erdemcanaz/Electronic-Load/Arşiv/ERDEM-GÜLCE/ERDEM/mosfet Vds current threshold.png

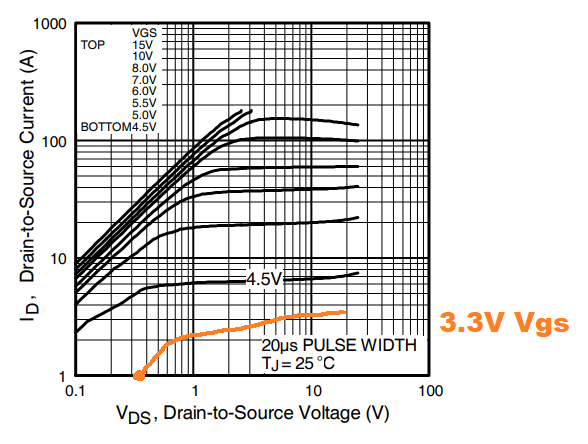
Arşiv/ERDEM-GÜLCE/ERDEM/mosfet Vds current threshold.png
