erdemcanaz/Electronic-Load/Arşiv/ERDEM-GÜLCE/LT SPICE FINISHED CIRCUITS/FINISHED DUMMY LOAD/FINISHED REVERSE VOLTAGE PROTECTION.png

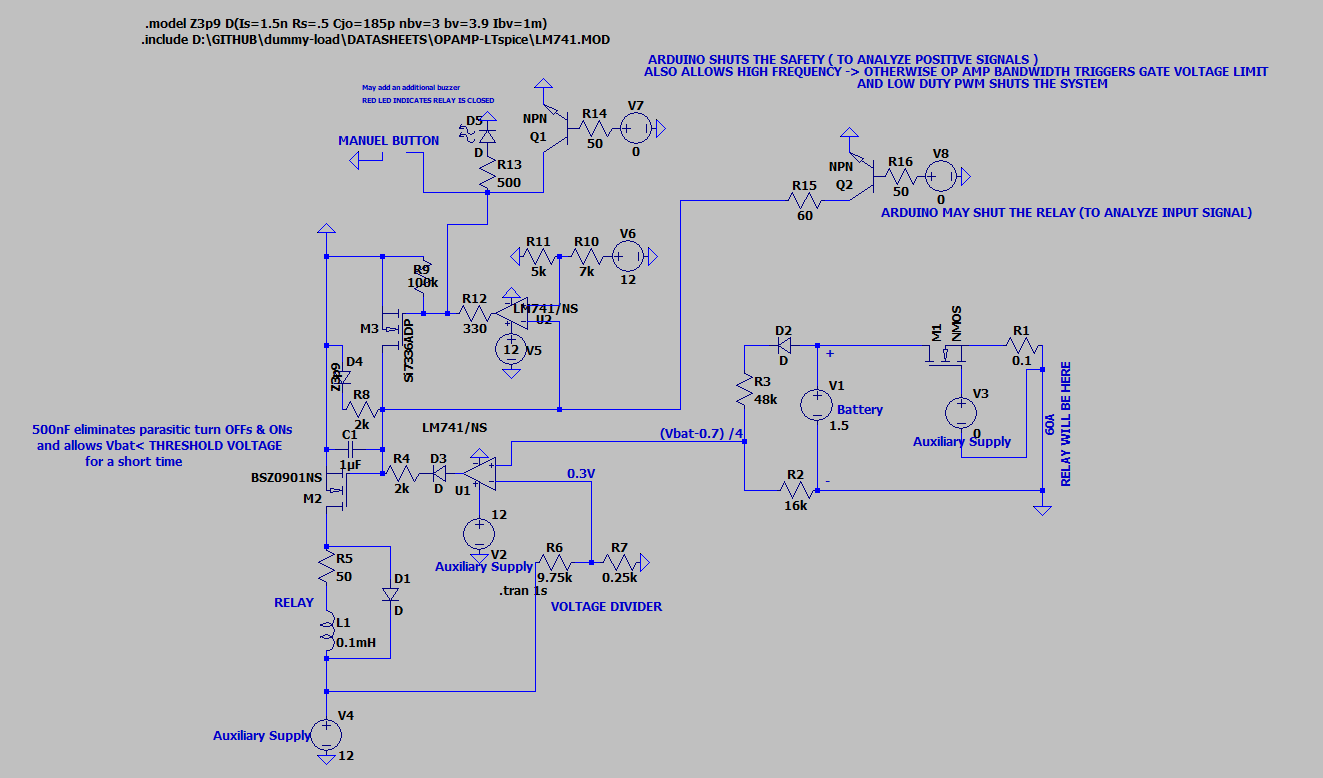
Arşiv/ERDEM-GÜLCE/LT SPICE FINISHED CIRCUITS/FINISHED DUMMY LOAD/FINISHED REVERSE VOLTAGE PROTECTION.png
