erdemcanaz/Electronic-Load/Arşiv/ERDEM-GÜLCE/LT SPICE FINISHED CIRCUITS/FINISHED DUMMY LOAD/MOSFET CONTROL PART.png

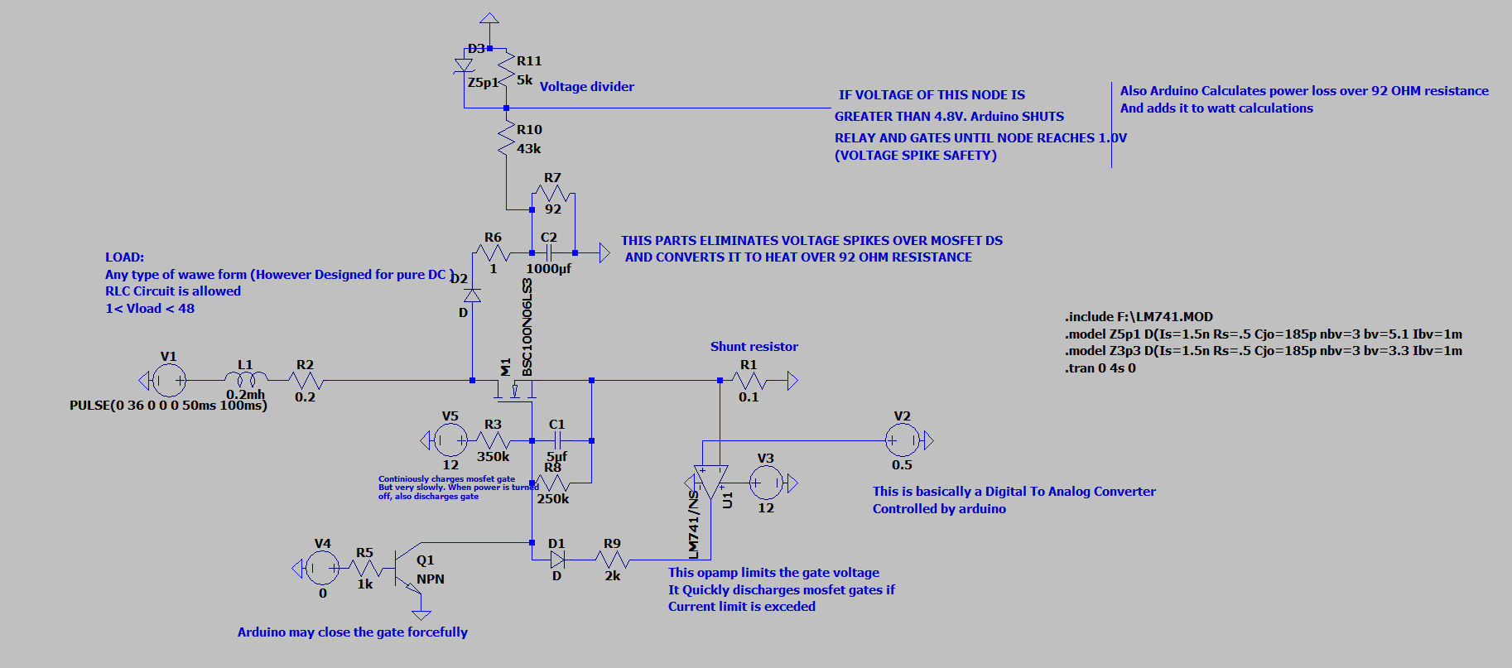
Arşiv/ERDEM-GÜLCE/LT SPICE FINISHED CIRCUITS/FINISHED DUMMY LOAD/MOSFET CONTROL PART.png
