erdemcanaz/Electronic-Load/Arşiv/ERDEM-GÜLCE/LT SPICE FINISHED CIRCUITS/R-OP AMP CURRENT CONTROL DC/image.png

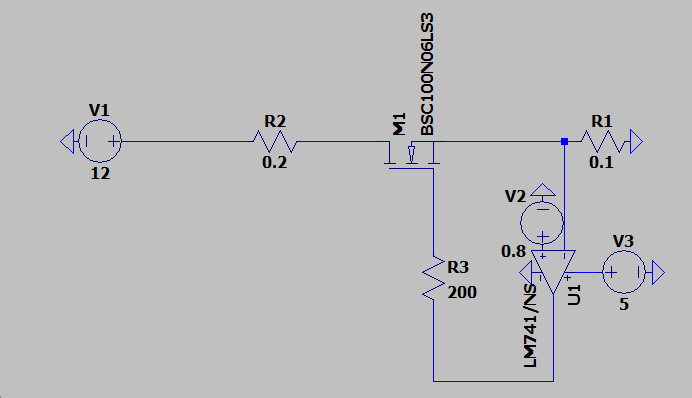
Arşiv/ERDEM-GÜLCE/LT SPICE FINISHED CIRCUITS/R-OP AMP CURRENT CONTROL DC/image.png
