erdemcanaz/Electronic-Load/Arşiv/ERDEM-GÜLCE/LT SPICE FINISHED CIRCUITS/REVERSE & LOW VOLTAGE PROTECTION WITH RELAY/image.png

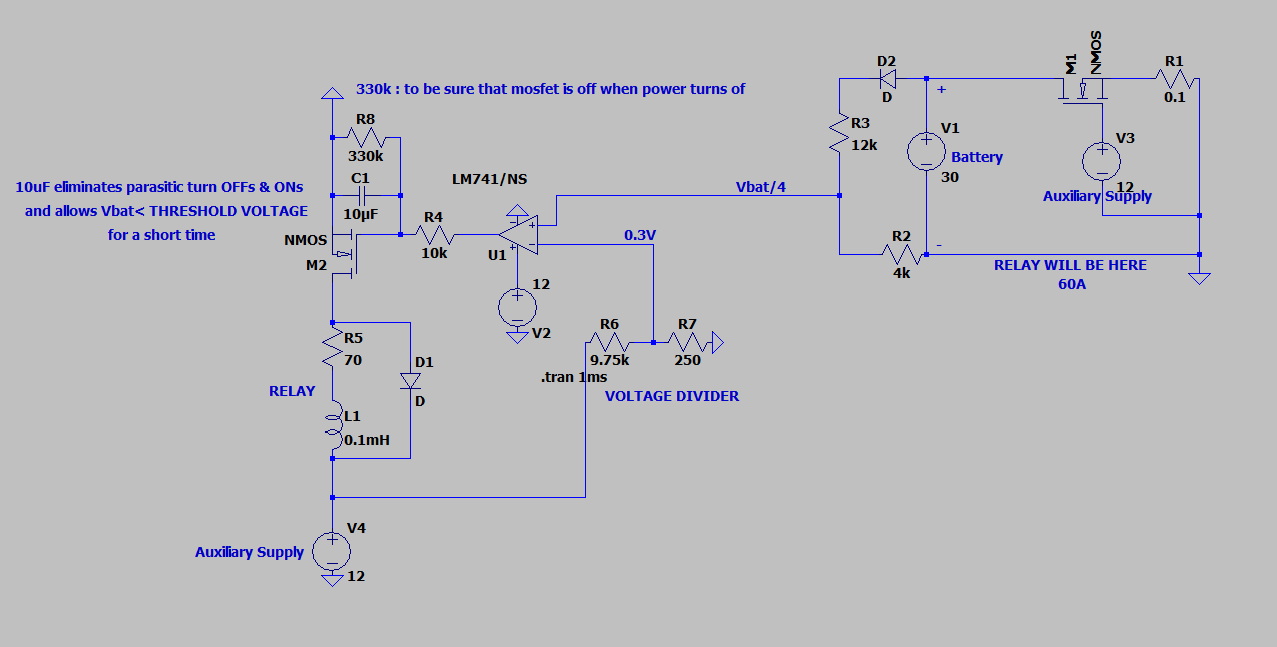
Arşiv/ERDEM-GÜLCE/LT SPICE FINISHED CIRCUITS/REVERSE & LOW VOLTAGE PROTECTION WITH RELAY/image.png
