erdemcanaz/Electronic-Load/Arşiv/ERDEM-GÜLCE/LT SPICE FINISHED CIRCUITS/REVERSE & LOW VOLTAGE PROTECTION WITH RELAY/Quick turn on relay- slow turn of relay.png

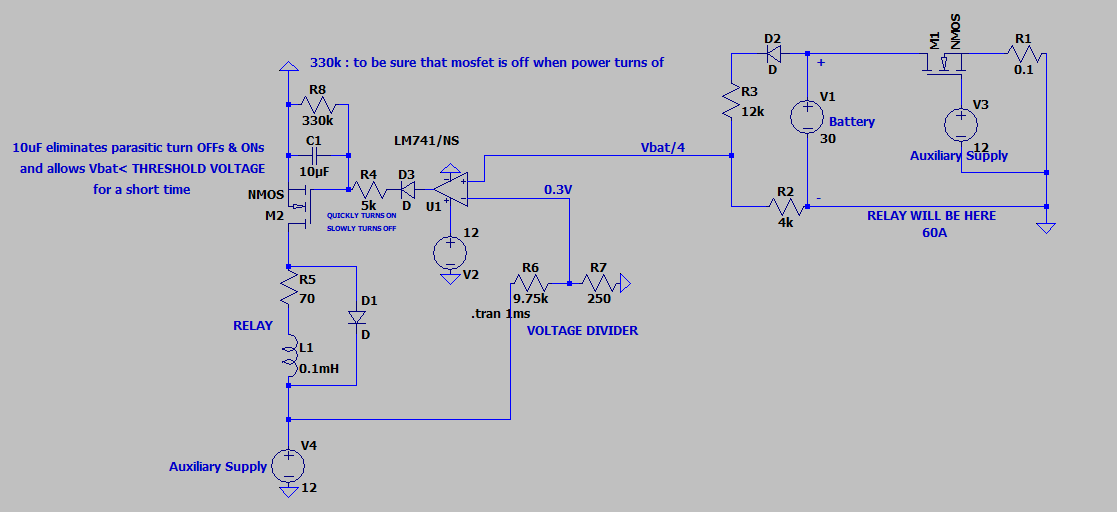
Arşiv/ERDEM-GÜLCE/LT SPICE FINISHED CIRCUITS/REVERSE & LOW VOLTAGE PROTECTION WITH RELAY/Quick turn on relay- slow turn of relay.png
