erdemcanaz/Electronic-Load/Arşiv/ERDEM-İLİM/PCB çizimleri/PCB çizimleri.step

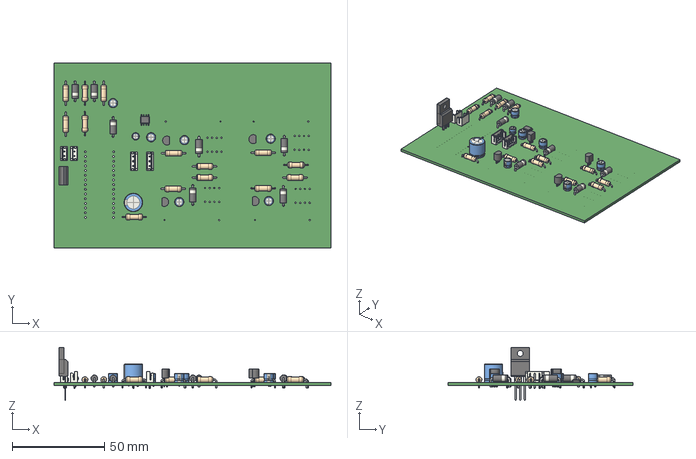
[picture p8: CAD file, 2021-12-23]
Arşiv/ERDEM-İLİM/PCB çizimleri/PCB çizimleri.step
150.0 x 100.0 x 28.9 mm
