erdemcanaz/Electronic-Load/Arşiv/ERDEM-GÜLCE/HOW TO USE GITHUB.txt

1: GITHUB going back in history: https://youtu.be/nsXx3npUOWY
