erdemcanaz/Electronic-Load/Arşiv/ERDEM-İLİM/PCB çizimleri/schematic/PCB çizimleri.pdf

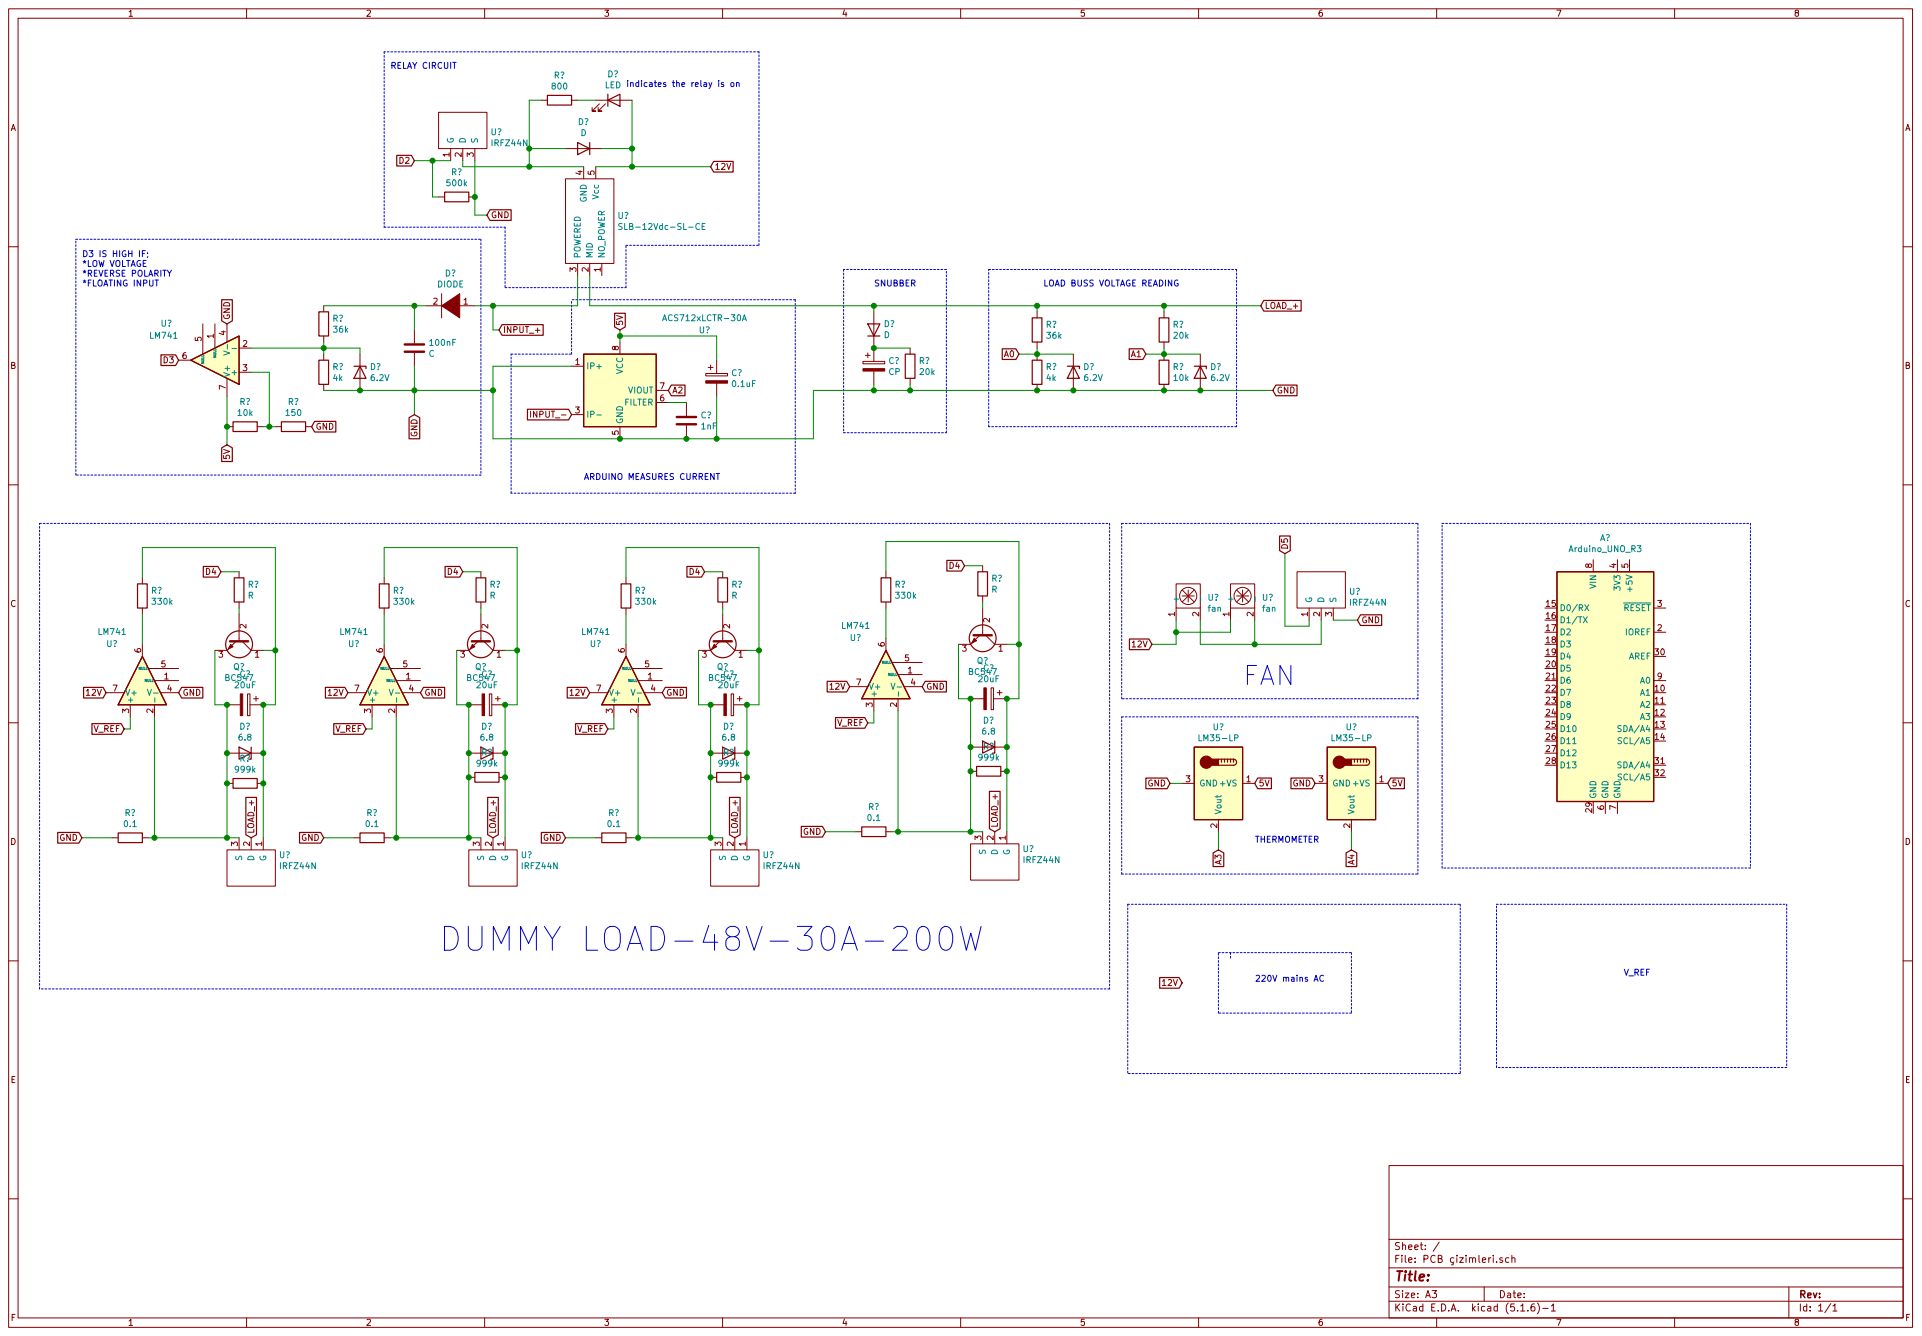
[picture p9: page 1]

indicates the relay is on

4 Vcc 5 U?SLB-12Vdc-SL-CE D?

D3 IS HIGH IF; *LOW VOLTAGE

LOAD BUSS VOLTAGE READING

File: PCB çizimleri.sch Sheet: /
