erdemcanaz/Electronic-Load/Simulation/Simulation.asc

C1: cap; 1µF; IC=0
C2: cap; 1µF
C3: cap; 1µF
C4: cap; 1µF
D1: zener; BZX84C8V2LT116
D2: zener; BZX84C8V2LT116
D3: zener; BZX84C8V2LT116
D4: zener; BZX84C8V2LT116
D5: LED
D6: LED
D7: LED
M1: nmos; IRFZ46N
M2: nmos; IRFZ46N
M3: nmos; IRFZ46N
M4: nmos; IRFZ46N
M5: nmos; IRFZ46N
Q1: npn; BC547B
Q2: npn; BC547B
Q3: npn; BC547B
Q4: npn; BC547B
R1: res; 0.1
R2: res; 0.2
R3: res; 1200k
R4: res; 10k
R5: res; 0
R6: res; 1
R7: res; 500k
R9: res; 1k
R10: res; 1k
R11: res; 10000k
R12: res; 0.1
R13: res; 500k
R16: res; 10000k
R17: res; 0.1
R18: res; 500k
R20: res; 2.3k
R22: res; 1100
R23: res; 0.01
R24: res; 10000k
R25: res; 0.1
R26: res; 500k
R29: res; 10000k
R30: res; 80
R31: res; 80
R32: res; 100k
R33: res; 3.2k
R34: res; 0.1k
R35: res; 1100
R36: res; 1100
U1: opamp2; LM741/NS
U2: opamp2; LM741/NS
U3: opamp2; LM741/NS
U4: opamp2; LM741/NS
U5: opamp2; LM741/NS
U6: opamp2; LM741/NS
V1: voltage; 5
V2: voltage; 3.3V
V3: voltage; 12V
V5: voltage; 0.3
Named nets: 0, IREF, 12V, 3.3V, HALT
.include D:\\GITHUB\\Electronic-Load\\Simulation\\LM741.MOD
INPUT+
-INPUT
max 0.5V
max 200k
max 10k
max 500
.tran 0 12 0
Current Adjustment
~1V
LED INDICATES LOW DRAIN VOLTAGE
FUSE
LED INDICATES FAN IS ACTIVATED
Grounds mosfet gates
POT1
POT2
POT3
SWITCH
FAN CURRENT LIMIT
Power supply
linear voltage regulator
FANS
