erdemcanaz/Electronic-Load/Arşiv/ERDEM-İLİM/LT spice models/draft1.asc

C1: cap; 4.7nF
R1: res; 3.3k
V1: voltage; PULSE(1 3 0.00025 1ns 1ns 0.00025 0.0005)
Named nets: 0
.tran 0.01
Exp4/ part2/ Q1/ a/ 2kHz,3.3kohm,4.7nF
Erdem Canaz/ 2374676
