erdemcanaz/Electronic-Load/Arşiv/ERDEM-GÜLCE/LT spice simulations/Draft1.asc

R1: res
R2: res
R3: res
R4: res
R5: res
R6: res
R7: res
R8: res
R9: res
R10: res
R11: res
R12: res
R13: res
R14: res
R15: res
R16: res
R17: res
R18: res
R19: res
R20: res
R21: res
R22: res
R23: res
R24: res
R25: res
R26: res
R27: res
R28: res
R29: res
R30: res
R31: res
R32: res
R33: res
R34: res
R35: res
R36: res
R37: res
R38: res
R39: res
R40: res
R41: res
R42: res
R43: res
R44: res
R45: res
R46: res
R47: res
R48: res
V1: voltage; 5
Named nets: 0
