erdemcanaz/Electronic-Load/Arşiv/ERDEM-GÜLCE/LT spice simulations/FINISHED DUMMY LOAD MOSFET PART.asc

C1: cap; 5µf
C2: cap; 1000µf
D1: diode
D2: diode
D3: zener; Z5p1
L1: ind; 0.2mh
M1: nmos; BSC100N06LS3
Q1: npn
R1: res; 0.1
R2: res; 0.2
R3: res; 350k
R5: res; 1k
R6: res; 1
R7: res; 92
R8: res; 250k
R9: res; 2k
R10: res; 43k
R11: res; 5k
U1: opamp2; LM741/NS
V1: voltage; SINE(20 18 20 0 0 0 0)
V2: voltage; 0.5
V3: voltage; 12
V4: voltage; 0
V5: voltage; 12
Named nets: 0
.include F:\\LM741.MOD
.tran 0 30s 0
.model Z5p1 D(Is=1.5n Rs=.5 Cjo=185p nbv=3 bv=5.1 Ibv=1m
.model Z3p3 D(Is=1.5n Rs=.5 Cjo=185p nbv=3 bv=3.3 Ibv=1m
IF VOLTAGE OF THIS NODE IS
GREATER THAN 4.8V. Arduino SHUTS
RELAY AND GATES UNTIL NODE REACHES 1.0V
THIS PARTS ELIMINATES VOLTAGE SPIKES OVER MOSFET DS
AND CONVERTS IT TO HEAT OVER 92 OHM RESISTANCE
(VOLTAGE SPIKE SAFETY)
Also Arduino Calculates power loss over 92 OHM resistance
And adds it to watt calculations
This is basically a Digital To Analog Converter
Controlled by arduino
This opamp limits the gate voltage
It Quickly discharges mosfet gates if
Current limit is exceded
Continiously charges mosfet gate
But very slowly. When power is turned
off, also discharges gate
Arduino may close the gate forcefully
Voltage divider
Shunt resistor
LOAD:
Any type of wawe form (However Designed for pure DC )
RLC Circuit is allowed
1< Vload < 48
