erdemcanaz/Electronic-Load/Arşiv/ERDEM-GÜLCE/LT spice simulations/FINISHED REVERSE VOLTAGE PROTECTION WITH RELAY.asc

C1: cap; 1µF; IC=7
D1: diode
D2: diode
D3: diode
D4: diode
D5: LED
L1: ind; 0.1mH
M1: nmos
M2: nmos; BSZ0901NS
M3: nmos; Si7336ADP
Q1: npn
Q2: npn
R1: res; 0.1
R2: res; 8k
R3: res; 24k
R4: res; 2k
R5: res; 50
R6: res; 9.75k
R7: res; 0.25k
R8: res; 3k
R9: res; 100k
R10: res; 7k
R11: res; 5k
R12: res; 330
R13: res; 500
R14: res; 330
R15: res; 60
R16: res; 50
U1: opamp2; LM741/NS
U2: opamp2; LM741/NS
V1: voltage; 12
V2: voltage; 12
V3: voltage; 0
V4: voltage; 12
V5: voltage; 12
V6: voltage; 12
V7: voltage; 0
V8: voltage; 0
Named nets: 0
.tran 1s
.include D:\\GITHUB\\dummy-load\\DATASHEETS\\OPAMP-LTspice\\LM741.MOD
RELAY WILL BE HERE
60A
RELAY
VOLTAGE DIVIDER
500nF eliminates parasitic turn OFFs & ONs
and allows Vbat< THRESHOLD VOLTAGE
Auxiliary Supply
Auxiliary Supply
Battery
+
-
(Vbat-0.7) /4
0.3V
for a short time
Auxiliary Supply
MANUEL BUTTON
ARDUINO SHUTS THE SAFETY ( TO ANALYZE POSITIVE SIGNALS )
RED LED INDICATES RELAY IS CLOSED
ARDUINO MAY SHUT THE RELAY (TO ANALYZE INPUT SIGNAL)
ALSO ALLOWS HIGH FREQUENCY -> OTHERWISE OP AMP BANDWIDTH TRIGGERS GATE VOLTAGE LIMIT
.model Z3p9 D(Is=1.5n Rs=.5 Cjo=185p nbv=3 bv=3.9 Ibv=1m)
May add an additional buzzer
AND LOW DUTY PWM SHUTS THE SYSTEM
