erdemcanaz/Electronic-Load/Arşiv/ERDEM-GÜLCE/LT spice simulations/RL- OP AMP CURRENT CONTROL FOR ALTERNATING DC.asc

C1: cap; 5µf
C2: cap; 2200µF
D1: diode
D2: diode
D3: zener; Z5p1
L1: ind; 0.2mh
M1: nmos; BSC100N06LS3
Q1: npn
R1: res; 0.1
R2: res; 0.2
R3: res; 30k
R4: res; 999k
R5: res; 1k
R6: res; 5k
R7: res; 92
U1: opamp2; LM741/NS
V1: voltage; SINE(12 12 50)
V2: voltage; 0.1
V3: voltage; 12
V4: voltage; 0
Named nets: 0
.include F:\\LM741.MOD
.tran 0 100ms 0
.model Z5p1 D(Is=1.5n Rs=.5 Cjo=185p nbv=3 bv=5.1 Ibv=1m
.model Z3p3 D(Is=1.5n Rs=.5 Cjo=185p nbv=3 bv=3.3 Ibv=1m
