erdemcanaz/Electronic-Load/Arşiv/ERDEM-GÜLCE/LT spice simulations/RL- OP AMP CURRENT CONTROL FOR DC.asc

C1: cap; 1µf
L1: ind; 0.001mH
M1: nmos; BSC100N06LS3
R1: res; 0.1
R2: res; 0.2
R3: res; 5k
R4: res; 4k
U1: opamp2; LM741/NS
V1: voltage; PULSE(0 48 0 0 0 25us 50us)
V2: voltage; 1
V3: voltage; 12
Named nets: 0
.include F:\\LM741.MOD
.tran 0 50ms 0
