erdemcanaz/Electronic-Load/Arşiv/ERDEM-GÜLCE/LT spice simulations/REVERSE VOLTAGE PROTECTION WITH RELAY.asc

C1: cap; 10µF
D1: diode
D2: diode
D3: diode
L1: ind; 0.1mH
M1: nmos
M2: nmos
R1: res; 0.1
R2: res; 4k
R3: res; 12k
R4: res; 5k
R5: res; 70
R6: res; 9.75k
R7: res; 250
R8: res; 330k
U1: opamp2; LM741/NS
V1: voltage; 30
V2: voltage; 12
V3: voltage; 12
V4: voltage; 12
Named nets: 0
.tran 1ms
.include D:\\GITHUB\\dummy-load\\DATASHEETS\\OPAMP-LTspice\\LM741.MOD
RELAY WILL BE HERE
60A
RELAY
VOLTAGE DIVIDER
330k : to be sure that mosfet is off when power turns of
10uF eliminates parasitic turn OFFs & ONs
and allows Vbat< THRESHOLD VOLTAGE
Auxiliary Supply
Auxiliary Supply
Battery
+
-
Vbat/4
0.3V
for a short time
QUICKLY TURNS ON
SLOWLY TURNS OFF
Auxiliary Supply
