erdemcanaz/Electronic-Load/Arşiv/ERDEM-GÜLCE/LT spice simulations/R- OP AMP CURRENT CONTROL DC.asc

M1: nmos; BSC100N06LS3
R1: res; 0.1
R2: res; 0.2
R3: res; 200
U1: opamp2; LM741/NS
V1: voltage; 12
V2: voltage; 0.8
V3: voltage; 5
Named nets: 0
.include F:\\LM741.MOD
.tran 0 1s 0
