erdemcanaz/Electronic-Load/PCB/electronic load/electronic load.kicad_pcb

## KiCad design PCB/electronic load/electronic load.kicad_pcb (2021-12-25)

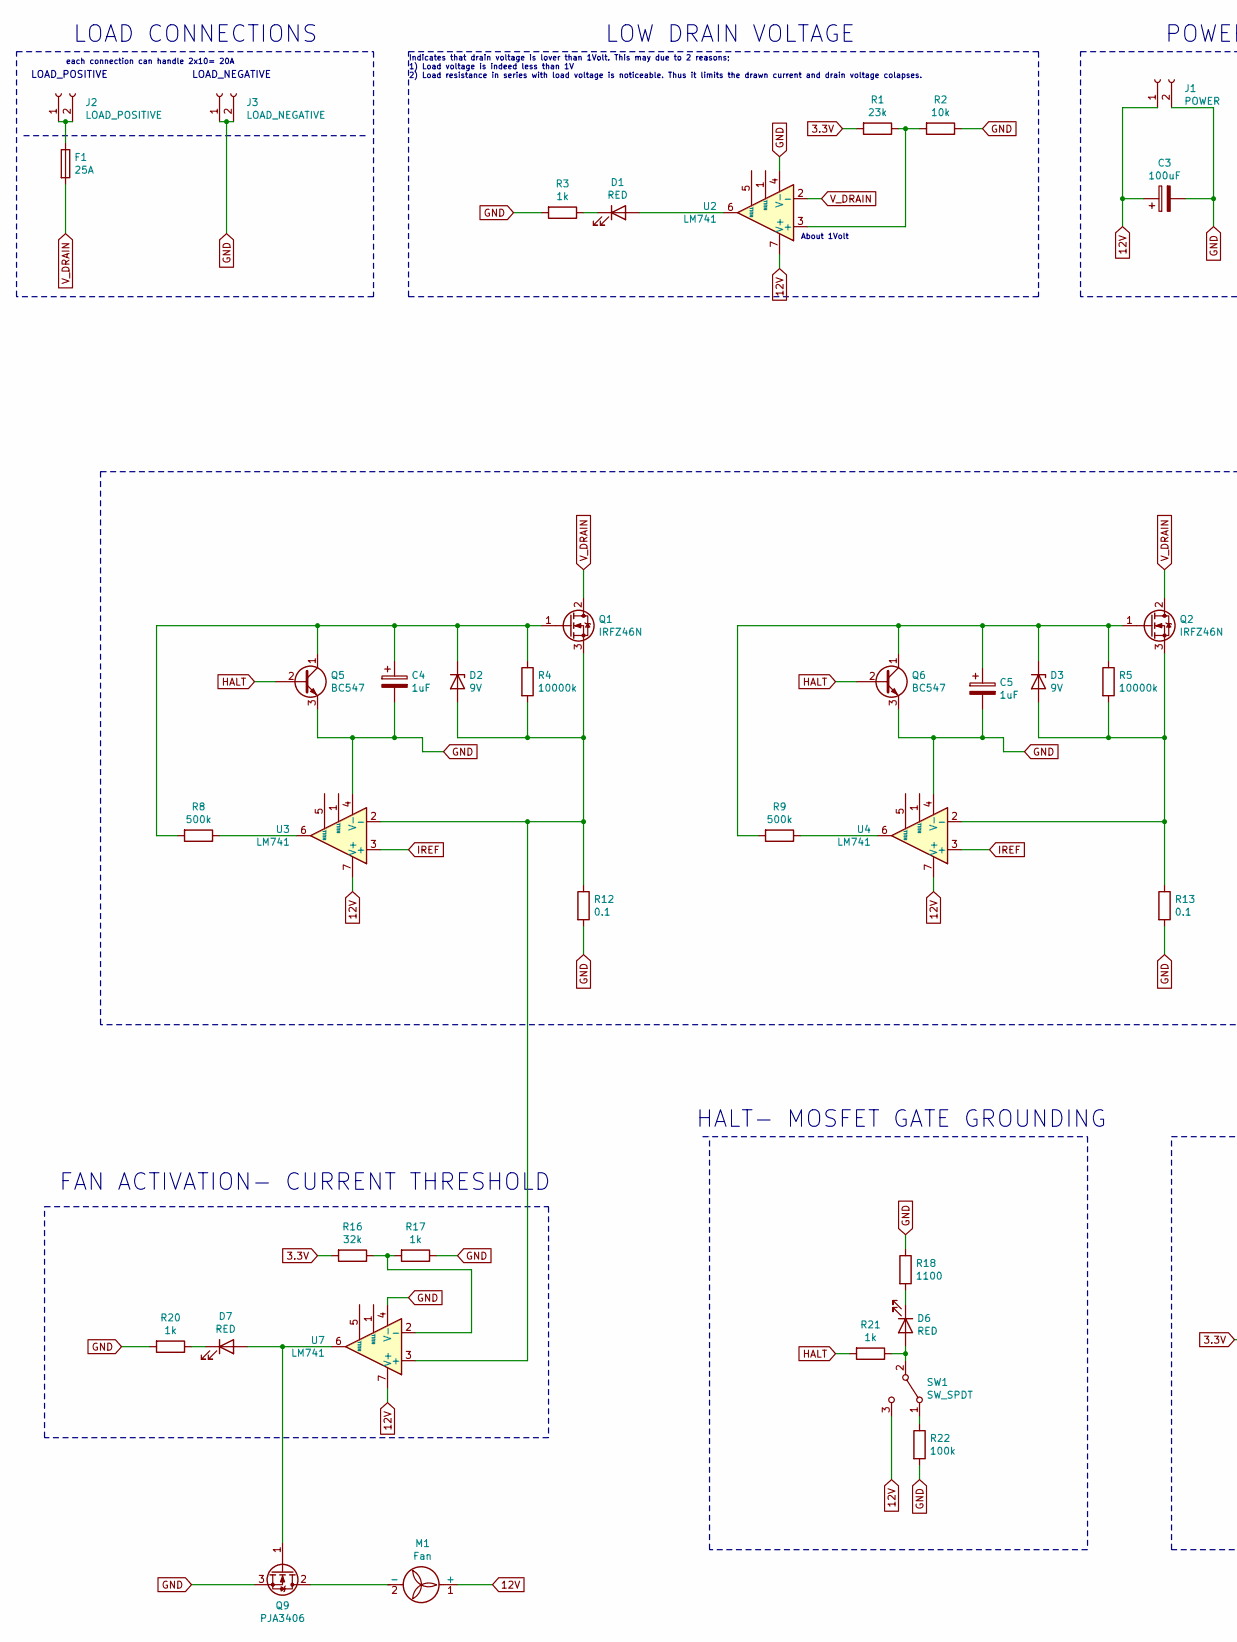
[picture p10: schematic electronic load.sch, part in row 1, column 1]

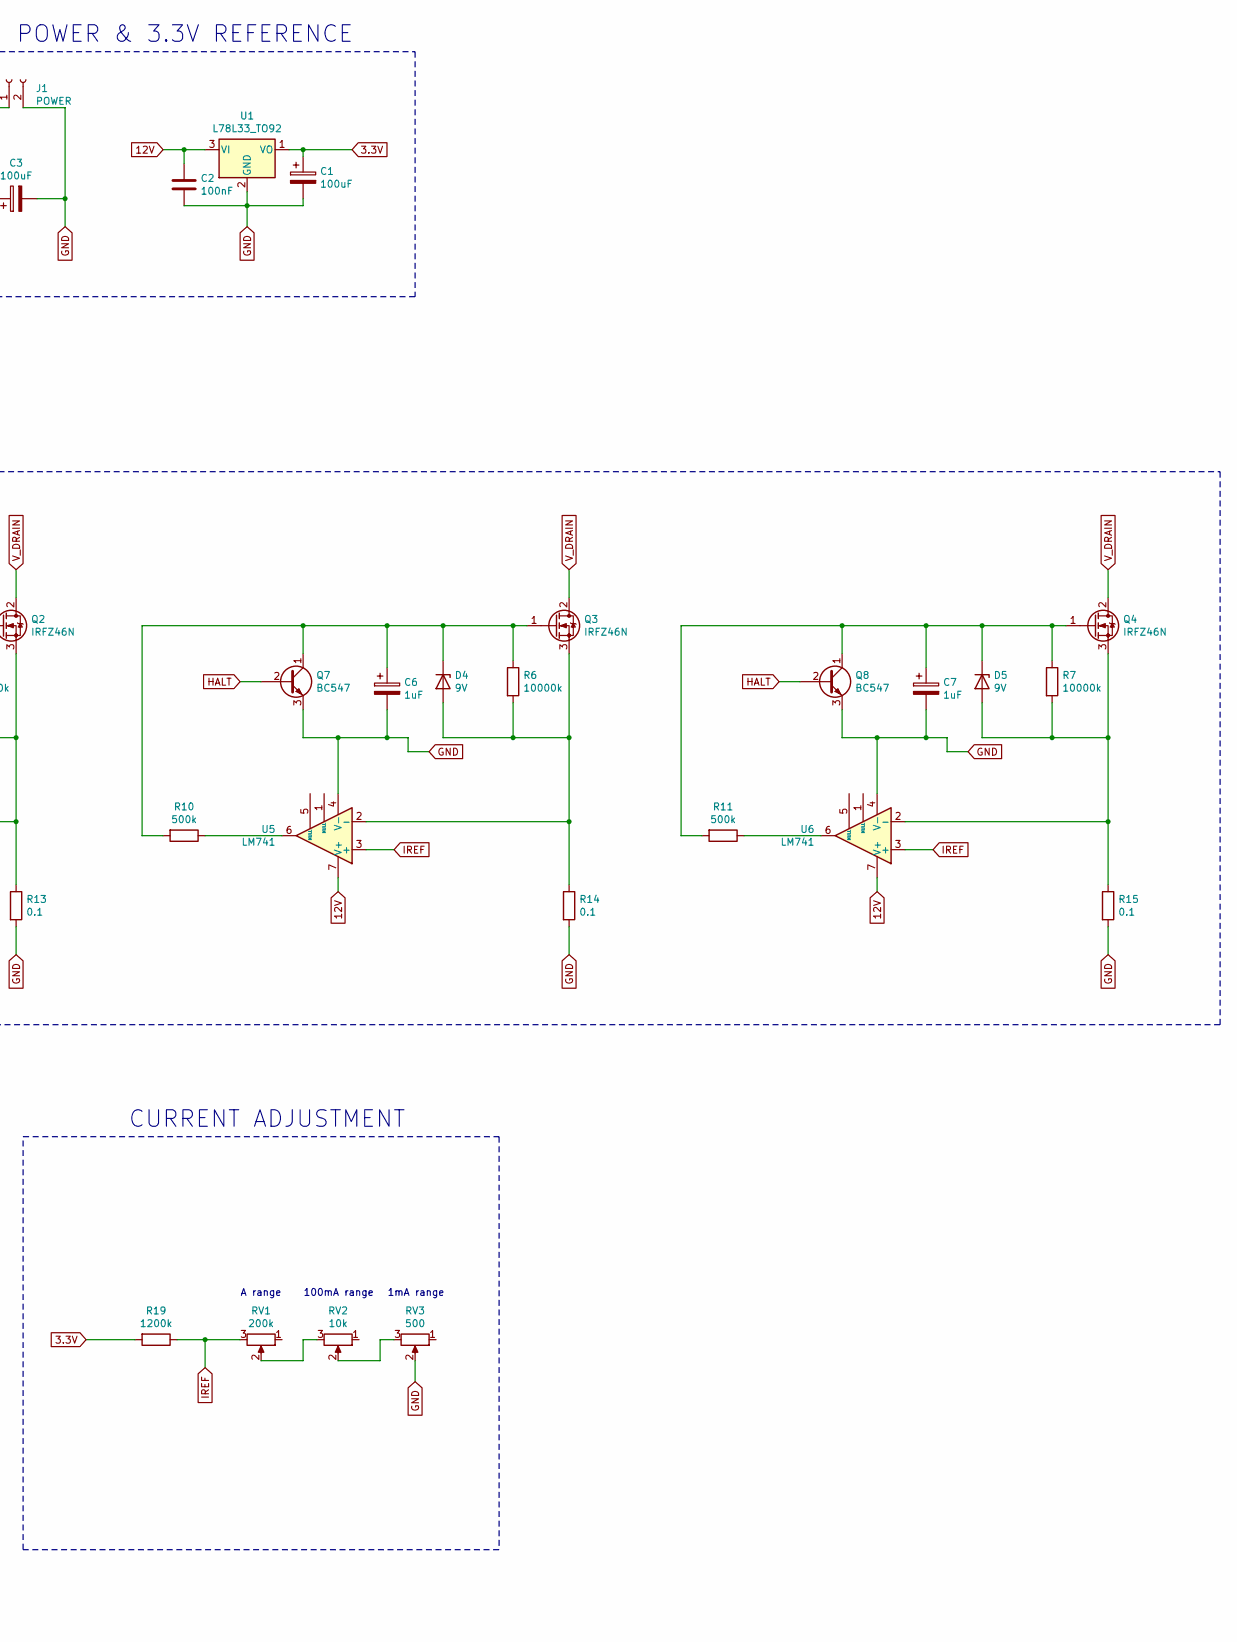
[picture p11: schematic electronic load.sch, part in row 1, column 2]

Parts:
C1, C3: 100uF; CP_Radial_D5.0mm_P2.00mm
C2: 100nF; CP_Radial_D5.0mm_P2.00mm
C4, C5, C6, C7: 1uF; CP_Radial_D5.0mm_P2.00mm
D1, D6, D7: RED; LED_D3.0mm_FlatTop
D2, D3, D4, D5: 9V; D_A-405_P12.70mm_Horizontal
F1: 25A; fuse
J1: POWER; klemens 2li
J2: LOAD_POSITIVE; klemens 2li
J3: LOAD_NEGATIVE; klemens 2li
M1: Fan; PinHeader_1x02_P2.00mm_Vertical
Q1, Q2, Q3, Q4: IRFZ46N; TO-220-3_Horizontal_TabUp
Q5, Q6, Q7, Q8: BC547; TO-92_Inline_Wide
Q9: PJA3406; SOT-23
R1: 23k; R_Axial_DIN0207_L6.3mm_D2.5mm_P7.62mm_Horizontal
R2: 10k; R_Axial_DIN0207_L6.3mm_D2.5mm_P7.62mm_Horizontal
R3, R17, R20, R21: 1k; R_Axial_DIN0207_L6.3mm_D2.5mm_P7.62mm_Horizontal
R4, R5, R6, R7: 10000k; R_Axial_DIN0207_L6.3mm_D2.5mm_P7.62mm_Horizontal
R8, R9, R10, R11: 500k; R_Axial_DIN0207_L6.3mm_D2.5mm_P7.62mm_Horizontal
R12, R13, R14, R15: 0.1; R_Axial_Power_L25.0mm_W9.0mm_P27.94mm
R16: 32k; R_Axial_DIN0207_L6.3mm_D2.5mm_P7.62mm_Horizontal
R18: 1100; R_Axial_DIN0207_L6.3mm_D2.5mm_P7.62mm_Horizontal
R19: 1200k; R_Axial_DIN0207_L6.3mm_D2.5mm_P7.62mm_Horizontal
R22: 100k; R_Axial_DIN0207_L6.3mm_D2.5mm_P7.62mm_Horizontal
RV1: 200k; pot
RV2: 10k; pot
RV3: 500; pot
SW1: SW_SPDT; PinHeader_1x03_P2.00mm_Horizontal
U1: L78L33_TO92; TO-92_Inline_Wide
U2, U3, U4, U5, U6, U7: LM741; DIP-8_W7.62mm

Connections:
3.3V: C1.1, R1.2, R16.2, R19.2, U1.1 (VO)
12V: C2.1, C3.1, J1.1, M1.1 (+), SW1.3 (C), U1.3 (VI), U2.7 (V+), U3.7 (V+), U4.7 (V+), U5.7 (V+), U6.7 (V+), U7.7 (V+)
GND: C1.2, C2.2, C3.2, C4.2, C5.2, C6.2, C7.2, J1.2, J3.1, J3.2, Q5.3 (E), Q6.3 (E), Q7.3 (E), Q8.3 (E), Q9.3 (S), R2.1, R3.2, R12.2, R13.2, R14.2, R15.2, R17.1, R18.1, R20.2, R22.2, RV3.2, U1.2 (GND), U2.4 (V-), U3.4 (V-), U4.4 (V-), U5.4 (V-), U6.4 (V-), U7.4 (V-)
HALT: Q5.2 (B), Q6.2 (B), Q7.2 (B), Q8.2 (B), R21.2
IREF: R19.1, RV1.3, U3.3 (+), U4.3 (+), U5.3 (+), U6.3 (+)
unnamed: C4.1, D2.1 (K), Q1.1 (G), Q5.1 (C), R4.1, R8.2
unnamed: C5.1, D3.1 (K), Q2.1 (G), Q6.1 (C), R5.1, R9.2
unnamed: C6.1, D4.1 (K), Q3.1 (G), Q7.1 (C), R6.1, R10.2
unnamed: C7.1, D5.1 (K), Q4.1 (G), Q8.1 (C), R7.1, R11.2
unnamed: D1.1 (K), R3.1
unnamed: D1.2 (A), U2.6
unnamed: D2.2 (A), Q1.3 (S), R4.2, R12.1, U3.2 (-), U7.3 (+)
unnamed: D3.2 (A), Q2.3 (S), R5.2, R13.1, U4.2 (-)
unnamed: D4.2 (A), Q3.3 (S), R6.2, R14.1, U5.2 (-)
unnamed: D5.2 (A), Q4.3 (S), R7.2, R15.1, U6.2 (-)
unnamed: D6.1 (K), R18.2
unnamed: D6.2 (A), R21.1, SW1.2 (B)
unnamed: D7.1 (K), R20.1
unnamed: D7.2 (A), Q9.1 (G), U7.6
unnamed: F1.1, J2.1, J2.2
unnamed: M1.2 (-), Q9.2 (D)
unnamed: R1.1, R2.2, U2.3 (+)
unnamed: R8.1, U3.6
unnamed: R9.1, U4.6
unnamed: R10.1, U5.6
unnamed: R11.1, U6.6
unnamed: R16.1, R17.2, U7.2 (-)
unnamed: R22.1, SW1.1 (A)
unnamed: RV1.2, RV2.3
unnamed: RV2.2, RV3.3
V_DRAIN: F1.2, Q1.2 (D), Q2.2 (D), Q3.2 (D), Q4.2 (D), U2.2 (-)

Notes on the sheet:
LOAD_POSITIVE
LOAD_NEGATIVE
LOAD CONNECTIONS
LOW DRAIN VOLTAGE
Indicates that drain voltage is lover than 1Volt. This may due to 2 reasons; 1) Load voltage is indeed less than 1V 2) Load resistance in series with load voltage is noticeable. Thus it limits the drawn current and drain voltage colapses.
About 1Volt
FAN ACTIVATION- CURRENT THRESHOLD
POWER & 3.3V REFERENCE
HALT- MOSFET GATE GROUNDING
A range
100mA range
1mA range
CURRENT ADJUSTMENT
each connection can handle 2x10= 20A

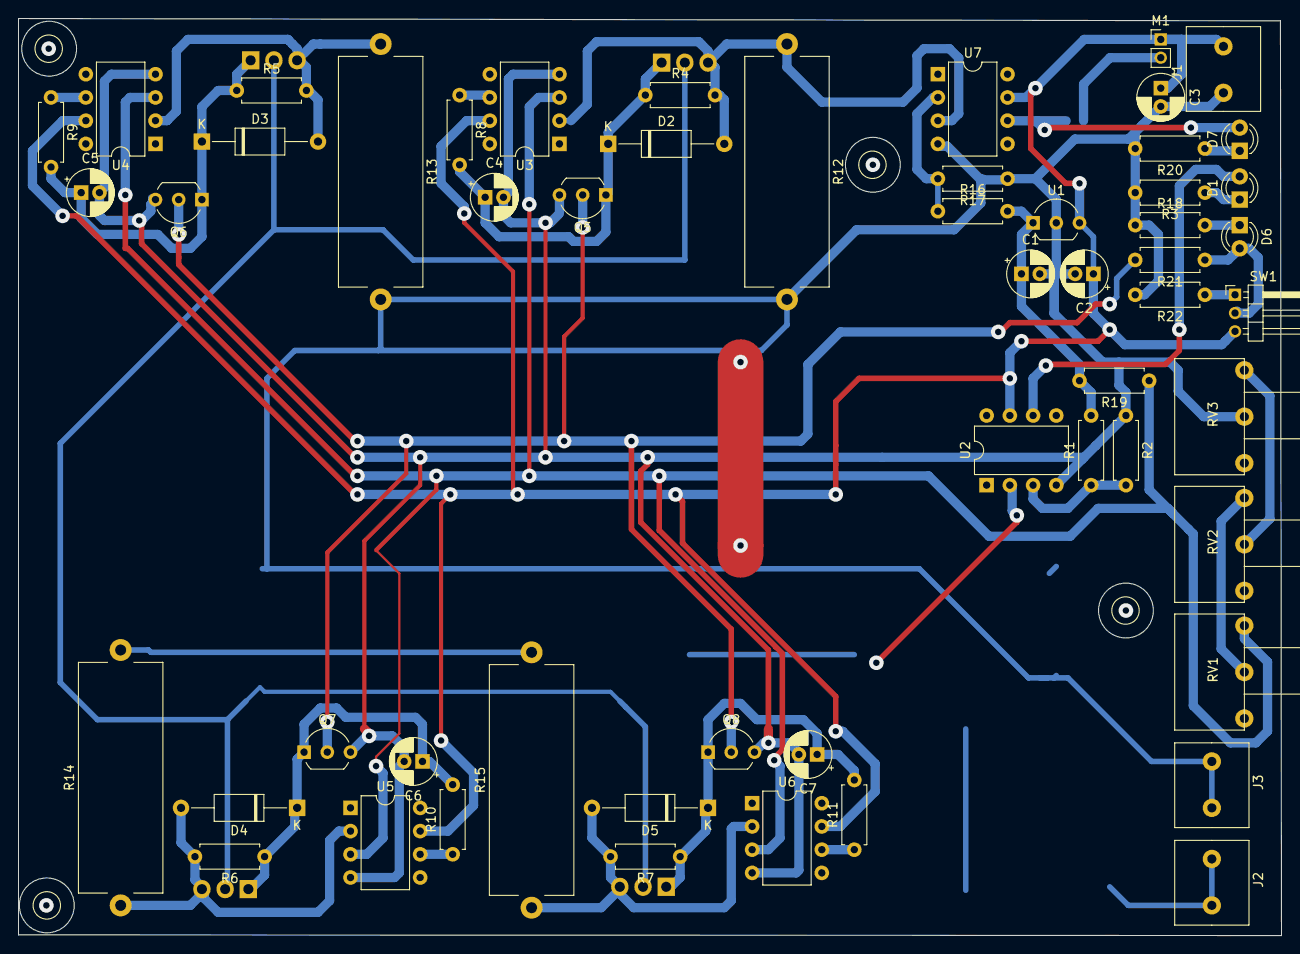
[picture p12: board electronic load.kicad_pcb from above]

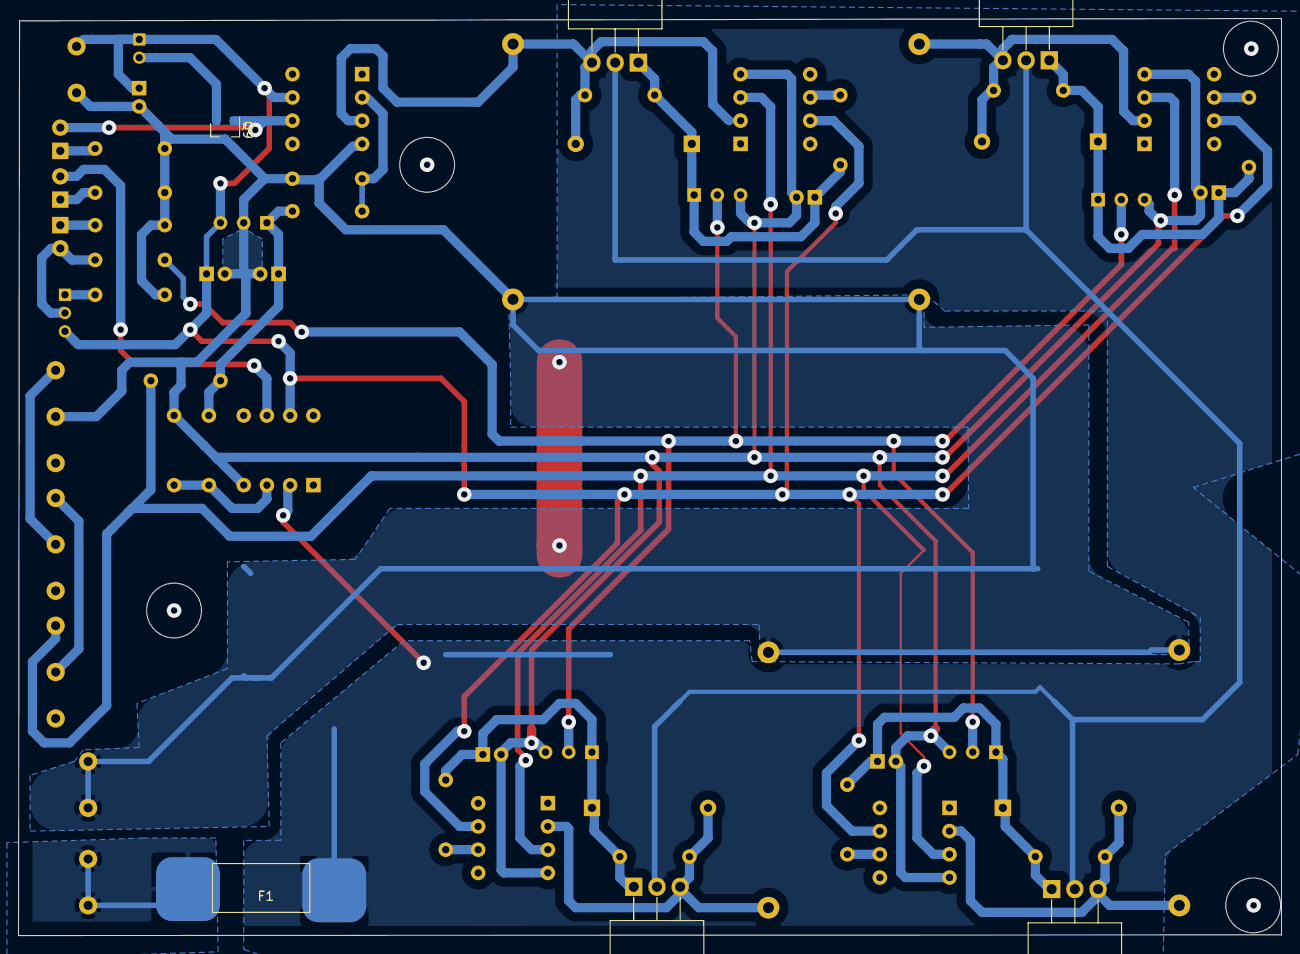
[picture p13: board electronic load.kicad_pcb from below]

Board: 2 copper layers, 138.2 x 100.3 mm, 61 parts (6 on the bottom side), 31 nets.
