erdemcanaz/Electronic-Load/Arşiv/ERDEM-İLİM/PCB çizimleri/PCB çizimleri.kicad_pcb

## KiCad design Arşiv/ERDEM-İLİM/PCB çizimleri/PCB çizimleri.kicad_pcb (2021-12-23)

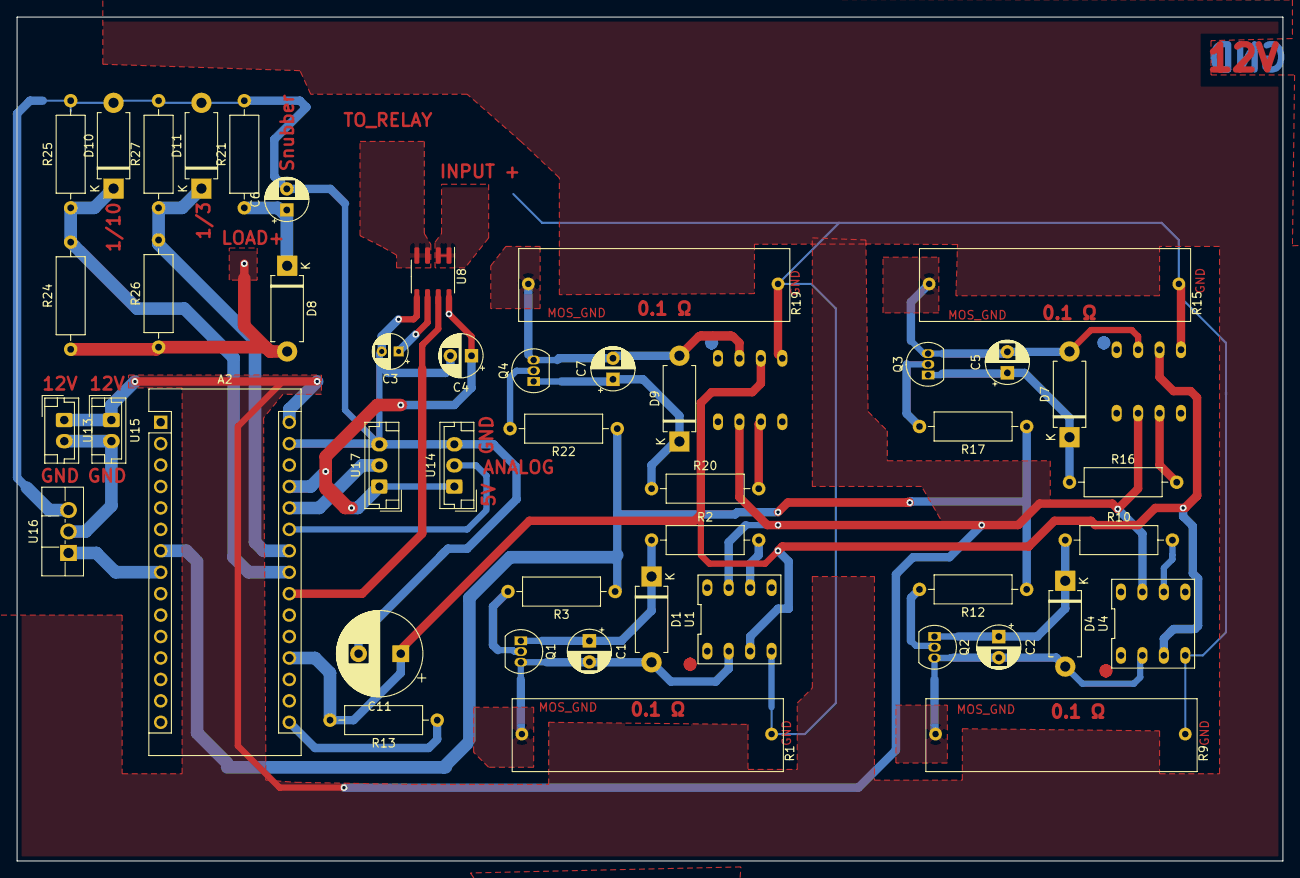
[picture p14: board PCB çizimleri.kicad_pcb from above]

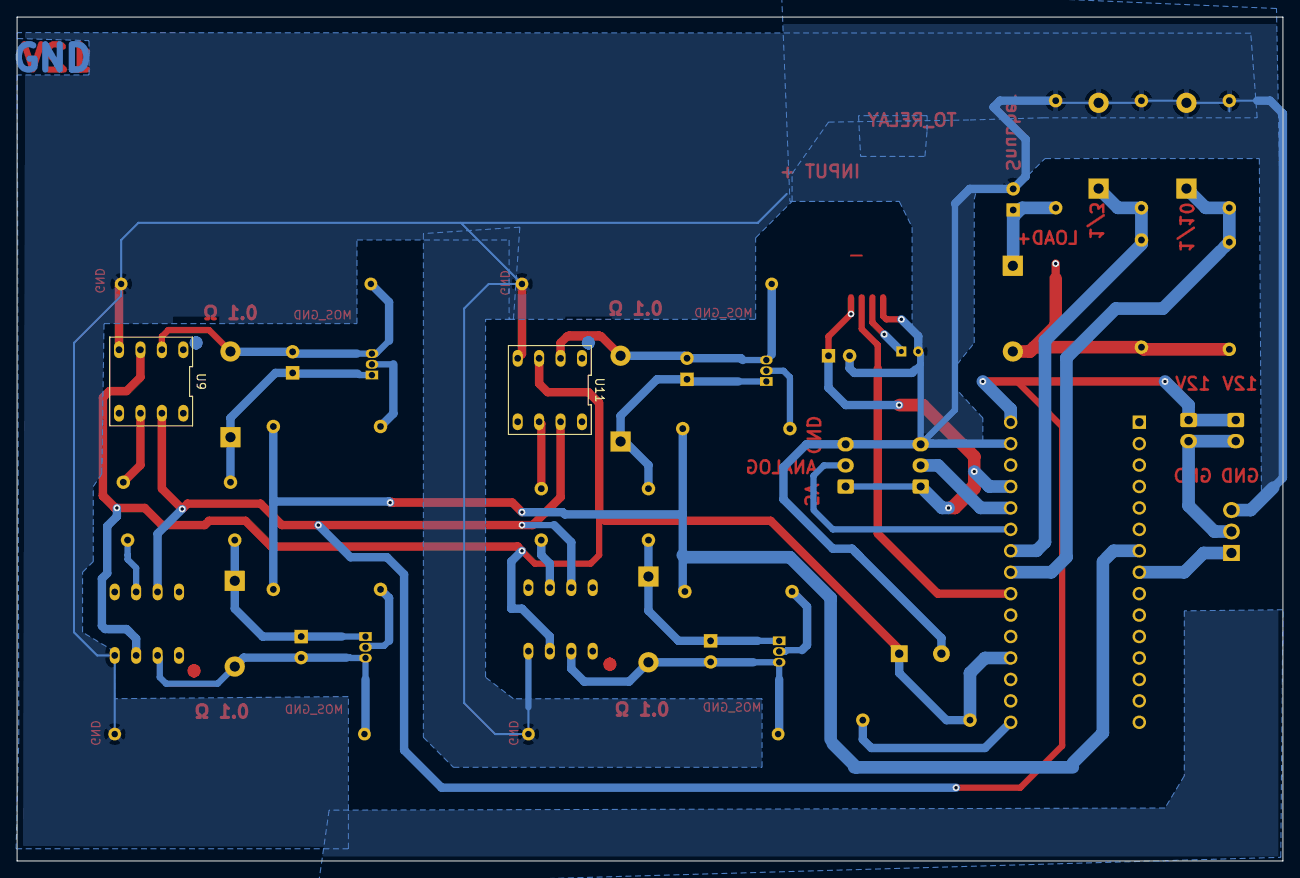
[picture p15: board PCB çizimleri.kicad_pcb from below]

Board: 2 copper layers, 150.0 x 100.0 mm, 48 parts (2 on the bottom side), 34 nets.

Parts:
A2: Arduino_Nano_v2.x; Arduino_Nano
C1, C2, C5, C7: 20uF; CP_Radial_D5.0mm_P2.50mm
C3: 1nF; CP_Radial_D4.0mm_P2.00mm
C4: 0.1uF; CP_Radial_D5.0mm_P2.50mm
C6: 100uF; CP_Radial_D5.0mm_P2.50mm
C11: 10uf; CP_Radial_D10.0mm_P5.00mm
D1, D4, D7, D9: 6.8; D_DO-15_P10.16mm_Horizontal
D8: D; D_DO-15_P10.16mm_Horizontal
D10, D11: 6.2V; D_DO-15_P10.16mm_Horizontal
Q1, Q2, Q3, Q4: BC547; TO-92_Inline
R1, R9, R15, R19: 0.1; 5W_tas
R2, R10, R16, R20: 330k; R_Axial_DIN0309_L9.0mm_D3.2mm_P12.70mm_Horizontal
R3, R12, R17, R22: 1k; R_Axial_DIN0309_L9.0mm_D3.2mm_P12.70mm_Horizontal
R13: 100k; R_Axial_DIN0309_L9.0mm_D3.2mm_P12.70mm_Horizontal
R21, R26: 20k; R_Axial_DIN0309_L9.0mm_D3.2mm_P12.70mm_Horizontal
R24: 36k; R_Axial_DIN0309_L9.0mm_D3.2mm_P12.70mm_Horizontal
R25: 4k; R_Axial_DIN0309_L9.0mm_D3.2mm_P12.70mm_Horizontal
R27: 10k; R_Axial_DIN0309_L9.0mm_D3.2mm_P12.70mm_Horizontal
U1, U4, U9, U11: LM741; DIP-8_296_ELL
U8: ACS712xLCTR-30A; SOIC-8_3.9x4.9mm_P1.27mm
U13, U15: fan; JST_EH_B2B-EH-A_1x02_P2.50mm_Vertical
U14, U17: LM35-LP; JST_EH_B3B-EH-A_1x03_P2.50mm_Vertical
U16: IRFZ44N; TO-220F-3_Vertical

Connections:
5V_ard: A2.27, C4.1, U8.8, U14.1, U17.1
12V: A2.30, U1.7, U4.7, U9.7, U11.7, U13.1, U15.1
CURRENT: A2.22, U8.7
D4: A2.7, R3.1, R12.1, R17.1, R22.1
D5: A2.8, U16.1
GND: A2.4, A2.29, C3.2, C4.2, C6.2, C11.2, D10.2, D11.2, R1.2, R9.2, R15.2, R19.2, R21.2, R25.2, R27.2, U1.4, U4.4, U8.5, U9.4, U11.4, U14.3, U16.3, U17.3
INPUT_+: U8.1, U8.2
LOAD_+: D8.2, R24.1, R26.1
unnamed: A2.16, R13.1
unnamed: C1.1, D1.1, Q1.1, R2.1
unnamed: C1.2, D1.2, Q1.3, R1.1, U1.2
unnamed: C2.1, D4.1, Q2.1, R10.1
unnamed: C2.2, D4.2, Q2.3, R9.1, U4.2
unnamed: C3.1, U8.6
unnamed: C5.1, D7.1, Q3.1, R16.1
unnamed: C5.2, D7.2, Q3.3, R15.1, U9.2
unnamed: C6.1, D8.1, R21.1
unnamed: C7.1, D9.1, Q4.1, R20.1
unnamed: C7.2, D9.2, Q4.3, R19.1, U11.2
unnamed: U8.3, U8.4
unnamed: Q1.2, R3.2
unnamed: Q2.2, R12.2
unnamed: Q3.2, R17.2
unnamed: Q4.2, R22.2
unnamed: R2.2, U1.6
unnamed: R10.2, U4.6
unnamed: R16.2, U9.6
unnamed: R20.2, U11.6
unnamed: U13.2, U15.2, U16.2
T1: A2.25, U14.2
T2: A2.26, U17.2
V_REF: A2.19, C11.1, R13.2, U1.3, U4.3, U9.3, U11.3
V_read_3: A2.24, D11.1, R26.2, R27.1
V_read_10: A2.23, D10.1, R24.2, R25.1
