erdemcanaz/Electronic-Load/(commit log)

2020-10-25 LT Spice simulations
    we have worked on some circuits enables us to control;
    1) current in R circuits
    2) current in RL circuits
    3) Reverse & low voltage protection
2020-10-25 Relay circuit feature
    Now relays turn on quickly however it turns of slowly over 330k resistor (about 3.5s to turn of). Thus, one may use voltage sources where voltage alternates between 0-48V
2020-10-25 Design paramaters
    40A-48V-400Watt DC
2020-10-25 Design parameters
    Design different voltage dividers for Ardino analog read
2020-10-26 Build Of Materials-BOM
    1-BOM list is created
    2- some youtube videos are added
    [BOM.xlsx]
2020-10-27 CURRENT CONTROL FOR ALL LOAD WAWE FORMS
    Our previous designs for "mosfet gate voltage control with opamp according to current measurement" was not doing well with coils and others waweforms rather than pure DC. "In this commit I have added A file FINISHED DUMMY LOAD MOSFET PART". Which works well for all waweforms and load characteristics and works perfect for pure DC. The circuit tries to find the suitable gate voltage at peak load voltage. Thus limits the current. However cant control the current only limits it (can control it if it is ~pure DC). Also added a snubber circuit to protect the mosfet. When a voltage spike occurs, the energy is transferred to a capacitor which is in paralel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
2020-10-28 REVERSE & LOW VOLTAGE PROTECTION
    floating votlage , Low voltage or negative voltage closese the relay and another opamp circuit holds it closed in 2ms electronical + Mechanical time until either
    1) User manually preses to the button
    2)Arduino shuts the safety( not obvious to all people who uses the device only to ones who read the manual)
    Also arduino may deliberately close the relay. (over voltage or some preparing)
    # ? # Why arduino may remove the protection ?
    Say we have a square wave: in such case the if frequency is increased opamp's output voltage decreases(bandwith) and triggers the safety feature {LOW DUTY PWM may also trigger } which turns off the relay. Arduino should anlyze t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
2020-10-28 REVERSE- FLOATING- LOW VOLTAGE PROTECTION
    Say we have a square wave: in such case the if frequency is increased opamp's output voltage decreases(bandwith) and triggers the safety feature {LOW DUTY PWM may also trigger } which turns off the relay. Arduino should an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
2021-03-29 .
    .
    [PCB çizimleri.kicad_pcb, PCB çizimleri.sch]
2021-03-29 schematic
    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
    [PCB çizimleri.sch]
2021-12-24 BOM
    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
    [BOM.xlsx]
2021-12-25 PCB schematic
    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
    [electronic load.kicad_pcb, electronic load.sch]
2021-12-25 PCB-not complated
    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
    [electronic load.sch]
2021-12-25 PCB- not finished
    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
    [electronic load.kicad_pcb, electronic load.sch]
2021-12-25 PCB finished
    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
    [electronic load.kicad_pcb, electronic load.sch]
